mircoick/MWT-Miniprojekt/project/MWT_Miniprojekt.pdf

# Entwurf und Implementierung eines Rat-Race Kopplers

Tassilo Wolf Hertling
Hochschule Bremen
Elektrotechnik B. Eng.
Bremen, Deutschland
thertling@stud.hs-bremen.de

Mirco Ick
Hochschule Bremen
Elektrotechnik B. Eng.
Bremen, Deutschland
mick001@stud.hs-bremen.de

Zusammenfassung—In dieser Arbeit wird ein breitbandiger Rat-Race-Koppler unter Verwendung von gestuften Impedanzresonatoren vorgestellt und validiert. Das vorgeschlagene Design
wurde fur eine Mittenfrequenz von ¨ | | 5, 0 GHz optimiert und deckt
den Frequenzbereich von 4, 5 GHz bis 5, 5 GHz mit einer relativen Bandbreite von mindestens 20 % ab. Die Systemimpedanz
an den Ein- und Ausgangen betr ¨ | agt ¨ | 50 Ω. Die experimentellen
und simulierten Ergebnisse zeigen, dass der Reflexionskoeffizient (S11) im gesamten Betriebsband unter −10 dB liegt, wahrend ¨ eine Isolation zwischen den Ausgangen von mindestens 15 dB ¨ garantiert wird. Das Design wurde auf einem RO4003C-Substrat (Dicke: 0, 8 mm) mit einer kompakten Gesamtgrundflache von ¨ unter 40 mm × 40 mm realisiert.
Index Terms—Koppler, Mikrowellenschaltungen, Rat-Race, gestufter Impedanzresonator (SIR), Breitband, RO4003C.
I. EINLEITUNG
Der Rat-Race Koppler ist einer der klassischen Strukturen der Koppler. Diese sind fundamentale Bauelemente der Hochfrequenztechnik, die eine Leistungs- und Signalaufteilung ermoglichen. ¨
Wie in Abbildung 1 dargestellt, weisen die Leitungszweige zwischen den Ports 1, 2, 3 und 4 jeweils eine elektrische Lange ¨ von λ/4 auf. Einzig der verbindende Pfad zwischen Port 1 und Port 4 ist als 3λ/4-Leitungsabschnitt dimensioniert.

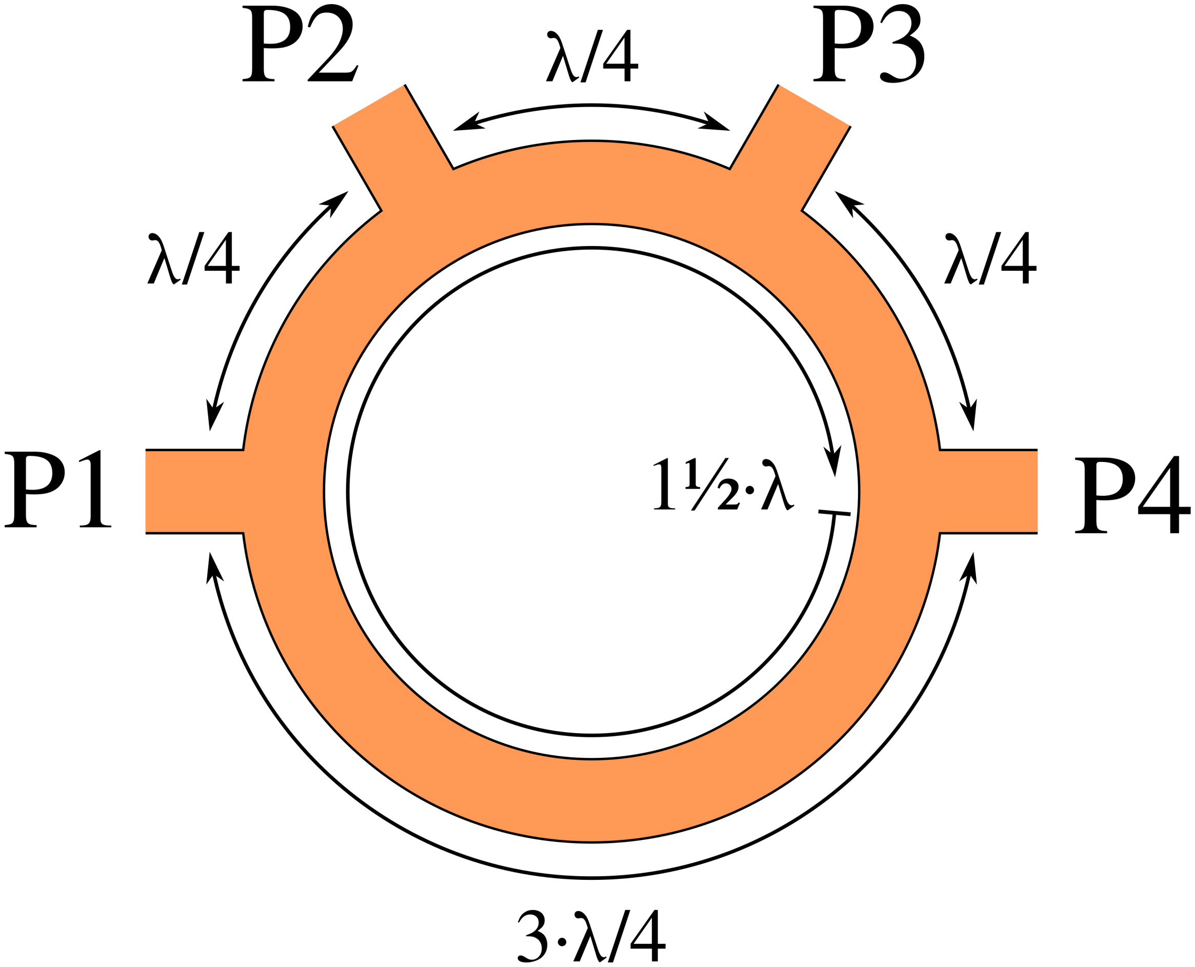
[picture p1: figure]

Abbildung 1. Struktur eines konventionellen Rat-Race-Kopplers gemaß [3] ¨

Aus dieser asymmetrischen Anordnung resultiert ein Gesamtumfang des Rings von 1

1/2 λ. Je nach gewahltem Ein- ¨ gangstor kommt es an den Ausgangstoren zu gezielten konstruktiven oder destruktiven Interferenzerscheinungen. Daraus resultieren die prazise Amplitudenteilung, die hohe Isolation ¨ der gegenuberliegenden Tore sowie die definierte Phasenbilanz ¨ (wahlweise 0

- oder 180◦ Phasenverschiebung). Eine Darstellung der verschiedenen Phasen bei verschiedener Signaleinspiesung ist der Abbildung 2 zu entnehmen.

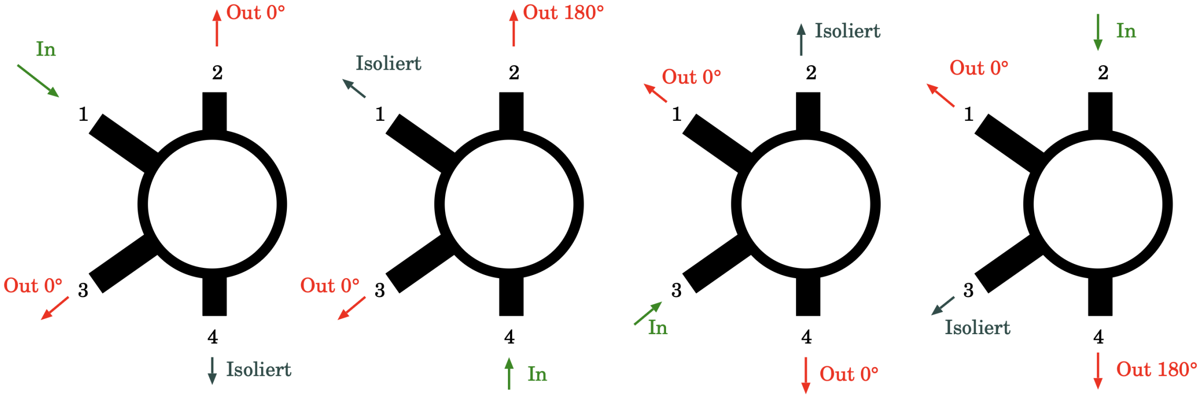
[picture p2: figure]

Abbildung 2. Beispielabbildung der Phasen eines Rat-Race Kopplers [2]

Klassische Ringkoppler sind schmalbandig, da sie auf eine Betriebsfrequenz ausgelegt sind. In [1] wurde untersucht wie dies vermieden werden kann.
Es wurden die Leitungsabschnitte des Rat-Race-Kopplers durch gestufte Impedanzresonatoren ersetzt. Diese Methodik ermoglichte eine Erweiterung der relativen Bandbreite ¨ auf mindestens 20 % im Frequenzbereich von 1, 7 GHz bis 2, 4 GHz (zentriert bei 2, 0 GHz), ohne dabei die geometrische
Grundflache der Schaltung zu vergr ¨ | oßern. ¨
Das Ziel dieser Arbeit bestand nun darin, diese Schaltung
auf einen hoheren Frequenzbereich von ¨ | | 4, 5 GHz bis 5, 5 GHz
bei einer Mittenfrequenz von 5, 0 GHz zu skalieren. Neben dieser Frequnezverschiebung waren weitere Vorgaben:
- Ein- und Ausgangsimpedanz: Z = 50 Ω
- Leistungsverteilung symmetrisch
- Ruckflussd ¨ | ampfung im gesamten Band: ¨ | S11 < −10 dB
- Isolation zwischen den Ausgangen: ¨ | S41 ≤ −15 dB
- Phasenfehler zwischen den Ausgangen: ¨
|S21 − S31| = 0◦ ± 5

◦
- Substrat: RO4003C, 0, 8 mm
- Maximale Platinen Große: ¨ | ≤ 40 mm × 40 mm
Dafur wurden zun ¨ | achst die Leitungsl ¨ | angen und -breiten ¨
berechnet. Anschließend wurde das Netzwerkmodell innerhalb der Simulationsumgebung AWR Microwave Office implementiert, um das Amplituden- und Phasenverhalten im Zielspektrum zu verbessern. Anschließend wurde die Platine geatzt und ¨ ein Vergleich zu den Theoriewerten durchgefuhrt. Auf diesen ¨ Entwicklungsverlauf wird nun in den nachfolgenden Kapiteln naher eingegangen. ¨

II. THEORIE
Fur die Bestimmung der Streuparameter (S-Parameter) und ¨ der Phasenbilanz zwischen den einzelnen Toren wird die Schaltung aus der Literatur als Basis herangezogen. Unter
Berucksichtigung der Resonanzbedingungen f ¨ | ur die jeweiligen ¨
λ/4- und 3λ/4-Leitungssegmente werden die geometrischen Abmessungen mathematisch hergeleitet.
Hierzu wird zunachst ¨ | uber die Lichtgeschwindigkeit ¨ | c und
die Mittenfrequenz f0 die Freiraumwellenlange ¨ | λ0 bestimmt:
λ0 = c f0 = | 2, 998 · 10⁸ m/s
| 5, 0 · 10⁹ Hz
= 59, 96 mm | (1)
In einer ersten Naherung wird f ¨ | ur die Wellenl ¨ | ange innerhalb ¨
des Dielektrikums (λm) die relative Permittivitatszahl des ¨ unbeschichteten Substrats (εr = 3, 55) herangezogen:

λm =

λ0
√
εr
| = 59, 96 mm
√
| 3, 55
≈ 31, 82 mm | (2)

Da diese Betrachtung die Feldausbreitung in die Luft ver-
nachlassigt, dient dieser Wert als erster Ausgangsparameter f ¨ | | ur¨
das anschließende Tuning und die finale Optimierung mittels der Tune-Funktion innerhalb von MW-Office.
Basierend auf der Materialwellenlange ¨ | λm werden die
Langen der Schaltungssegmente ¨ | L1 bis L7 berechnet. Wie in
Abbildung 3 dargestellt, wird die Ringstruktur zur Erweiterung der relativen Bandbreite mittels der Even-Odd-Methode in gestufte Impedanzresonatoren zerlegt. [1]

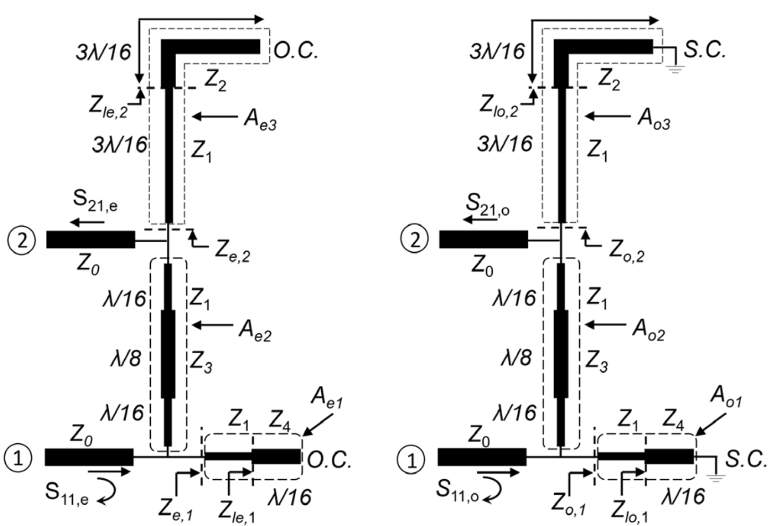
[picture p3: figure]

Abbildung 3. Leitungslangen aus der Literatur [1]. ¨

A. Berechnung der Leitungsabschnitte
Durch die Kopplung der im Paper definierten, von der
Wellenlange abh ¨ | angigen mathematischen Bedingungen mit der ¨
skalierten Materialwellenlange ¨ | λm = 31, 82 mm ergeben sich
die physikalischen Startlangen der Segmente wie folgt: ¨

L1 =

3λm
16

=

3 · 31, 82 mm
16
≈ 5, 97 mm | (3)

L2 + L5 = 2 ·

3λm
16

=

6 · 31, 82 mm
16

≈ 11, 93 mm (4)

L3 =

λm
8

=

31, 82 mm
8
≈ 3, 98 mm | (5)

L4 = 2 ·

λm
16

=

λm
8
≈ 3, 98 mm | (6)

L6 = L7 =

λm
16

=

31, 82 mm
16
≈ 1, 99 mm | (7)
Um die exakte Aufteilung der kombinierten Lange von ¨ | L2
und L5 zu bestimmen, wird die Symmetriebedingung der λ/4-Leitungen ausgenutzt. Dazu wurden zunachst die Leitungskur- ¨ ven (Bends) vernachlassigt. Unter dieser Annahmen muss der ¨ Pfad L2 exakt der elektrischen Lange der Leitung zwischen ¨ Port 1 und Port 3 entsprechen:

L2 = 2 · L7 + L4 =

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
≈ 7, 96 mm | (8)
Daraus ergibt sich die verbleibende Lange des Segments ¨ | L5
folgerichtig zu:

L5 = (L2 + L5) − L2 =

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
≈ 3, 98 mm (9)

Fur die Geometrie der Port Leitungen ( ¨ | L0) wird eine
fundamentale Lange von ¨ | λm/8 ≈ 3, 98 mm gewahlt. Da diese ¨
Leitungen exakt auf die Systemimpedanz von 50 Ω angepasst sind, andern sie den Wellenwiderstand theoretisch nicht und ¨ dienen im Layout primar der mechanischen Anbindung der ¨ SMA-Steckverbinder.
B. Spezifikation der Leitungsbreiten

Fur die erste Implementierung im Schaltungssimulator wer- ¨ den die Werte der Literatur [1] ubernommen. Diese Breiten ¨ sind in Tabelle II zusammengefasst. Auch hier wurde mithilfe des Tune-Tools spater genauere Anpassungen gemacht. ¨

Tabelle I
LEITUNGSBREITEN DER LITERATUR [1]
Designator | Physikalische Breite Wn (mm)
W0 | 1, 09
W1 | 0, 58
W2 | 0, 92
W3 | 0, 71
W4 | 1, 01
W5 | 0, 40

Diese Breiten bilden zusammen mit den berechneten
Langen das mathematische Fundament f ¨ | ur die Simulation in ¨
MW-Office.

III. NACHVOLLZUG

Die Schaltung wurde mithilfe von MW-Office implementiert. Hierbei wurden die Leitungen durch Mikrostreifen-Modelle (MLIN) modelliert. Die Verzweigungen an den Ports wurden
durch T-Stucke ( ¨ | MTEE) abgebildet, und das Substrat wurde
uber ein ¨ | MSUB-Element mit den spezifischen Materialpara-
metern des Rogers RO4003C-Substrats definiert (εr = 3, 55, h = 0, 8 mm, Verlustwinkel tan δ = 0, 0027, Kupferkaschierung t = 35 µm). Eine Darstellung des Simulationsmodels ist der Abbildung 4 zu entnehmen.

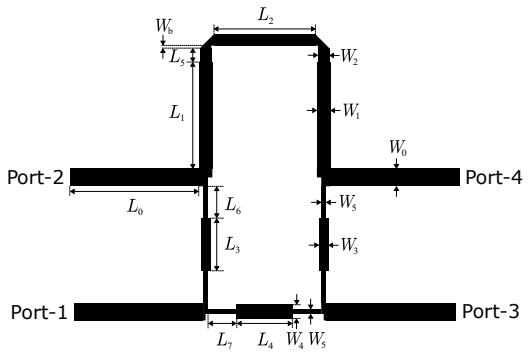
[picture p4: figure]
Port-2; Port-1; Port-4; Port-3

Abbildung 4. Topologie des Rat-Race Kopplers

Die erste Simulation mit den hergeleiteten Startwerten zeigte, eine Verschiebung der optimalen Parameter zu niedrigeren Frequenzen. Dies begrundet sich durch die effektive ¨ Permittivitat, da ein Teil des elektromagnetischen Feldes im ¨
Außenraum verlauft, was die gef ¨ | uhrte Wellenl ¨ | ange vergr ¨ | oßert. ¨
Ebenso besitzen geometrische Diskontinuitaten an T-St ¨ | ucken ¨
und Kurven parasitare Komponenten, welche die elektrische ¨
Gesamtlange des Rings k ¨ | unstlich verl ¨ | angern. ¨

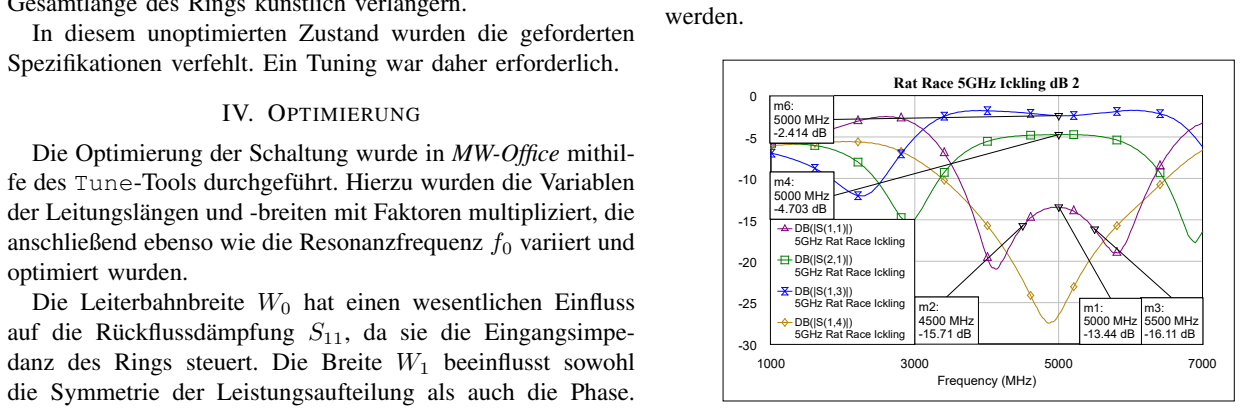
[picture p5: figure]
auf die Ruckflussd ¨; ampfung ¨; S11, da sie die Eingangsimpe-; werden.; Frequency (MHz); Rat Race 5GHz Ickling dB 2; 5000 MHz -2.414 dB; m4: 5000 MHz -4.703 dB

In diesem unoptimierten Zustand wurden die geforderten Spezifikationen verfehlt. Ein Tuning war daher erforderlich.

| IV. OPTIMIERUNG

Die Optimierung der Schaltung wurde in MW-Office mithilfe des Tune-Tools durchgefuhrt. Hierzu wurden die Variablen ¨ der Leitungslangen und -breiten mit Faktoren multipliziert, die ¨ anschließend ebenso wie die Resonanzfrequenz f0 variiert und optimiert wurden.
Die Leiterbahnbreite W0 hat einen wesentlichen Einfluss

danz des Rings steuert. Die Breite W1 beeinflusst sowohl die Symmetrie der Leistungsaufteilung als auch die Phase. Dies erfordert einen Kompromiss zwischen der Einhaltung der Amplitudensymmetrie und der Minimierung des Phasenfehlers zwischen den Ausgangen. Im vorliegenden Entwurf wurde die ¨ Optimierung des Phasenfehlers priorisiert. Da die Wellenlange ¨ λ mit der Frequenz f gekoppelt ist, verandert ¨ L0 die Mittenfrequenz und wurde auf 5 GHz angepasst. L1 beeinflusst die Symetrie des Phasenfehlers so wie die Verschiebung von S41, da es im 3/4λ Teil der Leitung liegt und somit das Verhaltniss ¨
andert. Die Zuleitungsl ¨ | ange ¨ | L6 wirkt sich vor allem auf die
Symmetrie der Bandbreite aus und wurde ebenfalls fur eine ¨ Mittenfrequenz von 5 GHz dimensioniert. Wb geht aus der MW-Office Schematic heraus.
Abbildung 5 zeigt, dass die wesentlichen Anforderungen
weitgehend erfullt wurden. Wie an Marker ¨ | m1 zu erkennen
ist, liegt die Mittenfrequenz der Anpassung bei 5 GHz. Das Minimum der Isolation S41 liegt zwar versetzt zu 5 GHz, was jedoch akzeptabel ist um die ubrigen Parameter besser ¨ einzustellen. Uber die gesamte geforderte Bandbreite von ¨
4, 5 GHz bis 5, 5 GHz bleibt die Ruckflussd ¨ | ampfung ¨ | S11 un-
terhalb von -10 dB. Zur Beurteilung der Isolation wird S41

Tabelle II
U¨ BERSICHT DER VERWENDETEN LEITUNGSBREITEN UND -LANGEN ¨

BASIEREND AUF [1]

Variable | Faktor | Wert in mm
w0 | 1,21 | 1,3189
w1 | 1,75 | 1,0150
w2 | 0,93 | 0,8556
w3 | 1,03 | 0,7313
w4 | 1,05 | 1,0605
w5 | 0,91 | 0,3640
l0 | 1,23 | 9,6317
l1 | 1,354 | 7,9522
l2 | – | 7,5595
l3 | 1,01 | 3,9545
l4 | 1,07 | 4,1894
l5 | 1,147 | 1,0318
l6 | 1,21 | 2,3688
l7 | 1,09 | 2,1338

betrachtet diese kann analog zur Isolation S31 zwischen den Ausgangen betrachtet werden. Dieser Wert bleibt im gesamten ¨ Frequenzband stets unter −15 dB. Zudem wurde die geforderte relative Bandbreite von mindestens 20% erreicht. Eine perfekte Amplitudensymmetrie konnte aufgrund der zuvor erwahnten ¨ Priorisierung des Phasenfehlers nicht vollstandig realisiert ¨

DB(|S(1,1)|) 5GHz Rat Race Ickling DB(|S(2,1)|)

5GHz Rat Race Ickling DB(|S(1,3)|) 5GHz Rat Race Ickling

DB(|S(1,4)|) 5GHz Rat Race Ickling | m2: 4500 MHz -15.71 dB | m1: m3: 5000 MHz 5500 MHz -13.44 dB -16.11 dB

Abbildung 5. Simulierte S-Parameter, Betrag in dB, des Rat-Race-Kopplers bei 5 GHz

In Abbildung 6 ist zu erkennen, dass die Phasendifferenz uber die gesamte betrachtete Bandbreite innerhalb einer Tole- ¨ ranz von 5° liegt.

V. FERTIGUNG
Nach der theoretischen Betrachtung wurde die Platine nun
geazt und anschließend gel ¨ | otet. In Abbildung 7 ist die fertig ¨
gelottete Platine zu sehen. ¨
| VI. MESSUNG
Vor der messtechnischen Charakterisierung wurde der Netzwerkanalysator kalibriert. Anschließend wurden die S-Parameter der gefertigten Schaltung ermittelt.
Abbildung 8 zeigt, dass das gemessene S11 gegenuber der ¨ Simulation leicht frequenzverschoben ist. Dennoch bleibt der
Wert uber die gesamte Bandbreite unterhalb von ¨ | −10 dB,
sodass eine ausreichend gute Anpassung gewahrleistet ist. ¨

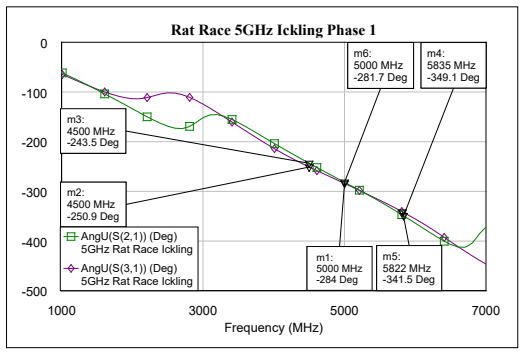
[picture p6: figure]
Frequency (MHz); Rat Race 5GHz Ickling Phase 1; m3: 4500 MHz -243.5 Deg; m2: 4500 MHz -250.9 Deg AngU(S(2,1)) (Deg)

| m6: m4: 5000 MHz 5835 MHz -281.7 Deg -349.1 Deg
5GHz Rat Race Ickling AngU(S(3,1)) (Deg) 5GHz Rat Race Ickling | m1: 5000 MHz -284 Deg | m5: 5822 MHz -341.5 Deg

Abbildung 6. Simulierter Phasenverlauf des Rat-Race-Kopplers bei 5 GHz

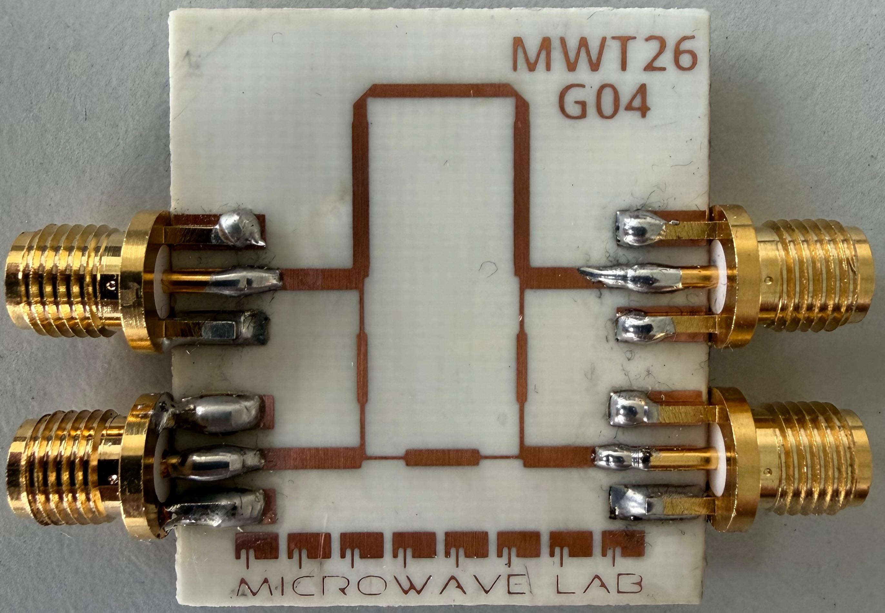
[picture p7: figure]

Abbildung 7. Fotografie der geatzten Platine des Rat-Race-Kopplers ¨

S21 ist Koharent und divergiert erst ab ¨ | 5, 5 GHz von den
Theoriewerten.
Aus Abbildung 9 geht hervor, dass S41, im unteren Frequenzberreich, leicht verschoben von der EM-Analyse
verlauft. ¨ | S31 verhalt sich im gew ¨ | unschten Frequenzbereich ¨
weitesgehend erwartend. Es ist jedoch eine Asymeterie von von 2 dB festzustellen.
In Abbildung 10 ist eine deutliche Abweichung der gemessenen Phasendifferenz von den theoretischen Werten zu
beobachten. Dies ist primar auf ¨ | S31 zuruckzuf ¨ | uhren, dessen ¨
Phasenverlauf einen unerwarteten Verlauf hat. Im Gegensatz

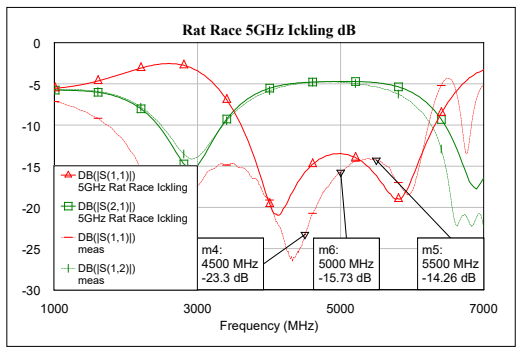
[picture p8: figure]
Frequency (MHz); Rat Race 5GHz Ickling dB

DB(|S(1,1)|) 5GHz Rat Race Ickling DB(|S(2,1)|)

5GHz Rat Race Ickling DB(|S(1,1)|) meas | m4: m6: | m5:
DB(|S(1,2)|) meas | 4500 MHz 5000 MHz -23.3 dB -15.73 dB | 5500 MHz -14.26 dB

Abbildung 8. Vergleich der EM-Analyse und gemessenen S-Parameter S11 und S21

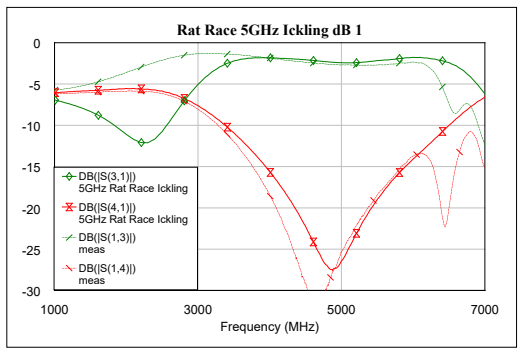
[picture p9: figure]
Frequency (MHz); Rat Race 5GHz Ickling dB 1; 5GHz Rat Race Ickling DB(|S(1,3)|) meas; DB(|S(1,4)|) meas

DB(|S(3,1)|) 5GHz Rat Race Ickling DB(|S(4,1)|)

Abbildung 9. Vergleich der EM-Analyse und gemessenen S-Parameter S31

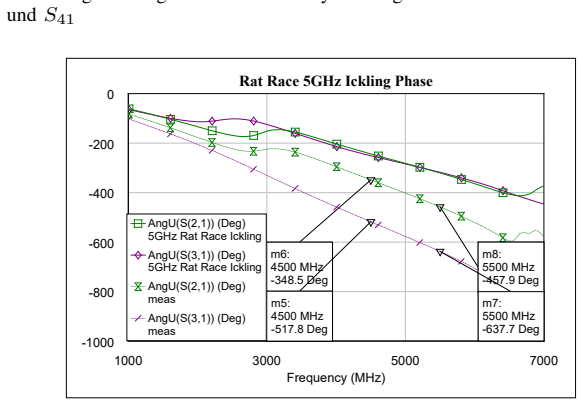
[picture p10: figure]
und S41; Frequency (MHz); Rat Race 5GHz Ickling Phase; meas AngU(S(3,1)) (Deg) meas; m5: 4500 MHz -517.8 Deg; m7: 5500 MHz -637.7 Deg

AngU(S(2,1)) (Deg) 5GHz Rat Race Ickling

AngU(S(3,1)) (Deg) 5GHz Rat Race Ickling AngU(S(2,1)) (Deg) | m6: 4500 MHz -348.5 Deg | m8: 5500 MHz -457.9 Deg

Abbildung 10. Vergleich des simulierten und gemessenen Phasenverlaufs

dazu folgt die Phase von S21 den simulierten Werten lediglich mit einem konstanten Offset.

VII. DISKUSSION
Die gefertigte Schaltung zeigt insgesamt ein Verhalten, das unter Berucksichtigung typischer Fertigungstoleranzen gut mit ¨ dem theoretischen Modell ubereinstimmt. Eine signifikante ¨ Abweichung zeigt sich lediglich im Phasenverlauf von S31.
Diese Diskrepanz konnte auf die sehr kleinen Leitungsl ¨ | angen ¨
zuruckzuf ¨ | uhren sein, da hier bereits minimale Abweichungen ¨
der Langen enorme Kurven ¨ | anderungen mit sich bringen. ¨

VIII. FAZIT
Es wurde im besprochenen Design ein Rat-Race-Koppler fur¨ eine Mittenfrequenz von 5 GHz entworfen, simuliert und messtechnisch validiert. Trotz leichter Asymmetrien und messbarer Phasenabweichungen in einem der Koppelpfade erfullt das ¨ realisierte Design die grundlegenden Systemanforderungen, insbesondere hinsichtlich der relativen Bandbreite und der
Ruckflussd ¨ | ampfung. ¨

LITERATUR

[1] A. K. Sahoo und K. Rawat, ”

A wideband rat-race coupler using stepped impedance resonator“, 2018 IEEE MTT-S International Wireless Symposium (IWS), Chengdu, China, 2018, pp. 1-3.
[2] Prof. Dr. S. Peik, ”Coupler and power divider”, Vorlesungsskript, Hochschule Bremen, 2026.
[3] https://de.wikipedia.org/wiki/Ringkoppler, 2026
