mircoick/MWT-Miniprojekt/project/MW-Office/5GHz Rat Race Ickling.dxf

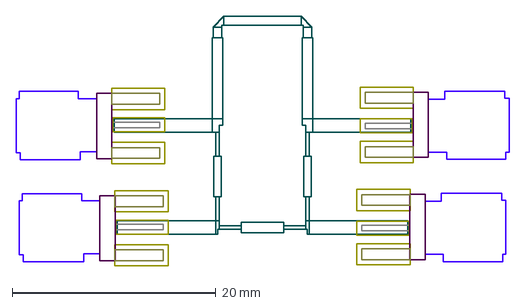
[picture p11: CAD file, 2026-07-04]
project/MW-Office/5GHz Rat Race Ickling.dxf
48.3 x 24.4 mm
