mircoick/MWT-Miniprojekt/project/Schematic.pdf

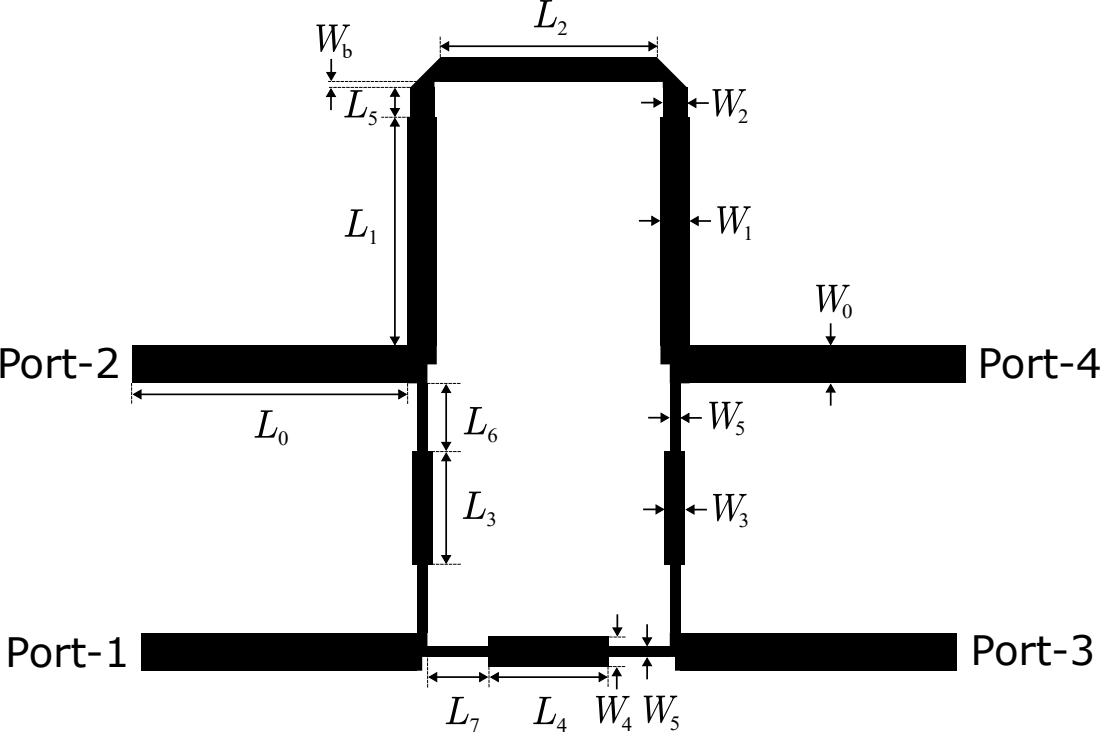
[picture p12: page 1]
Port-2; Port-1; Port-4; Port-3
