mircoick/MWT-Miniprojekt/project/db.pdf

# Rat Race 5GHz Ickling dB

-5

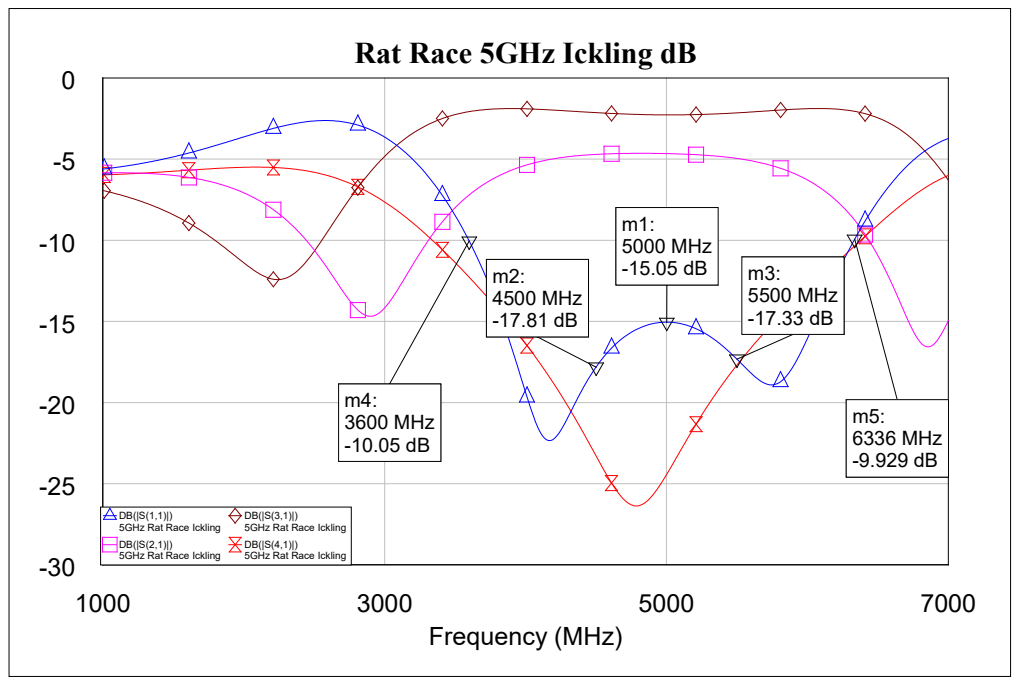
[picture p13: page 1]
Frequency (MHz); 5500 MHz -17.33 dB

5000 MHz -15.05 dB m2: 4500 MHz -17.81 dB | m3:

m4:
3600 MHz -10.05 dB | m5: 6336 MHz -9.929 dB

DB(|S(1,1)|) DB(|S(3,1)|) 5GHz Rat Race Ickling 5GHz Rat Race Ickling 5GHz Rat Race Ickling 5GHz Rat Race Ickling
