mircoick/MWT-Miniprojekt/project/phase.pdf

## Rat Race 5GHz Ickling Phase

200

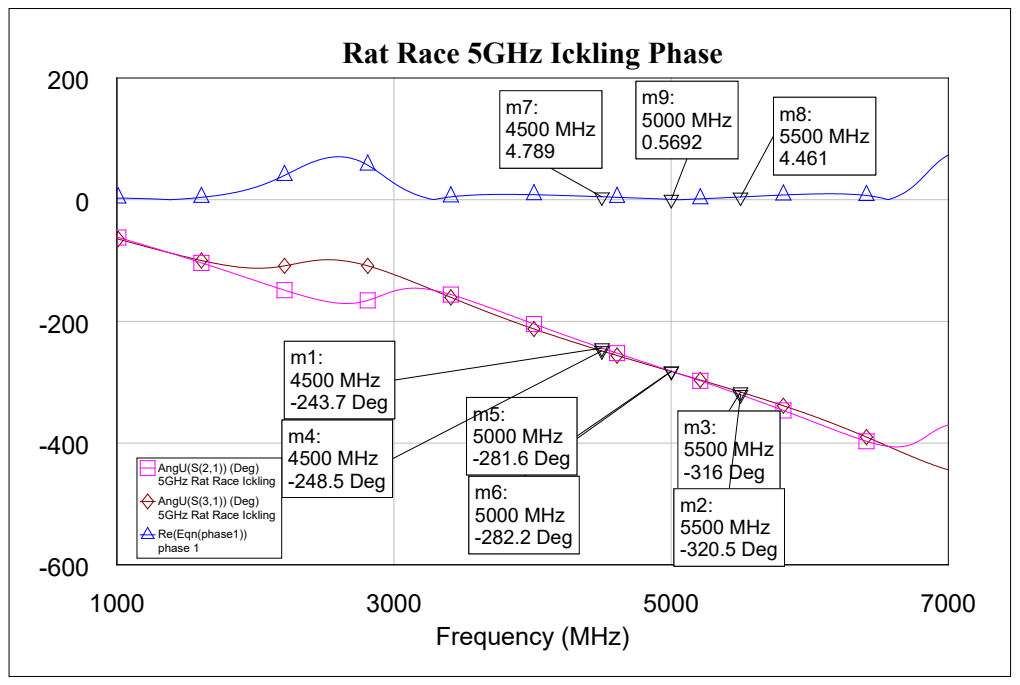
[picture p14: page 1]
Frequency (MHz); m9: 5000 MHz 0.5692; m8: 5500 MHz 4.461; m7: 4500 MHz 4.789; m3: 5500 MHz; AngU(S(2,1)) (Deg)

m1: 4500 MHz -243.7 Deg m4: | m5: 5000 MHz

4500 MHz -248.5 Deg 5GHz Rat Race Ickling AngU(S(3,1)) (Deg) 5GHz Rat Race Ickling Re(Eqn(phase1)) phase 1 | -281.6 Deg m6: 5000 MHz -282.2 Deg | -316 Deg m2: 5500 MHz -320.5 Deg
