mircoick/MWT-Miniprojekt/project/MW-Office/dbcompare1.pdf

# Rat Race 5GHz Ickling dB 1

-5

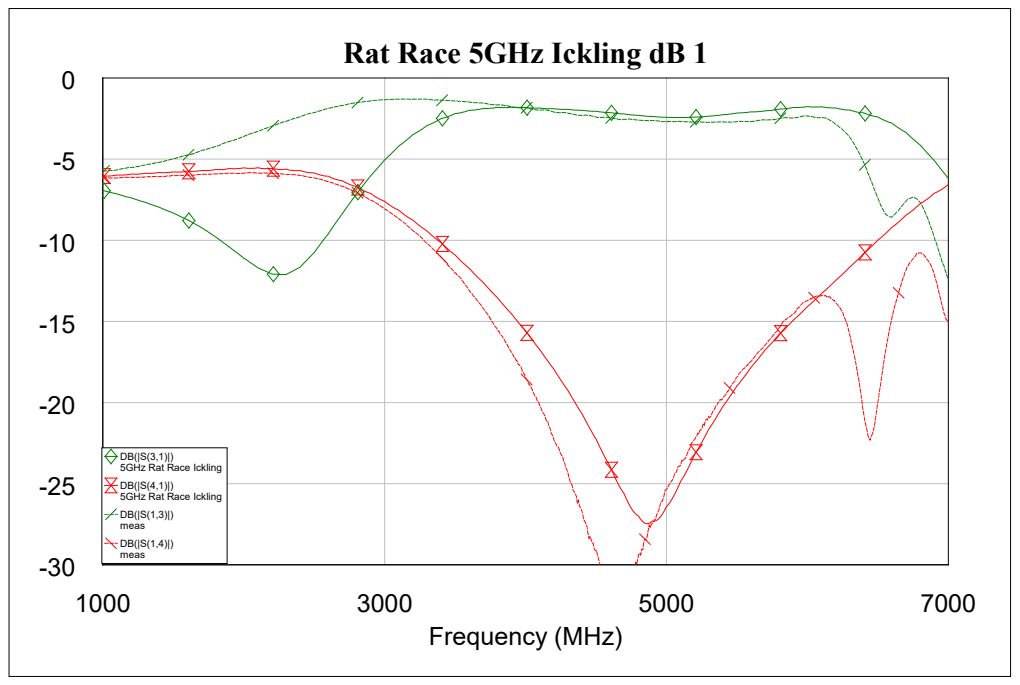
[picture p15: page 1]
Frequency (MHz); DB(|S(3,1)|) 5GHz Rat Race Ickling

5GHz Rat Race Ickling
DB(|S(1,3)|) meas DB(|S(1,4)|) meas
