mircoick/MWT-Miniprojekt/project/MW-Office/dbcompare2.pdf

## Rat Race 5GHz Ickling dB

-5

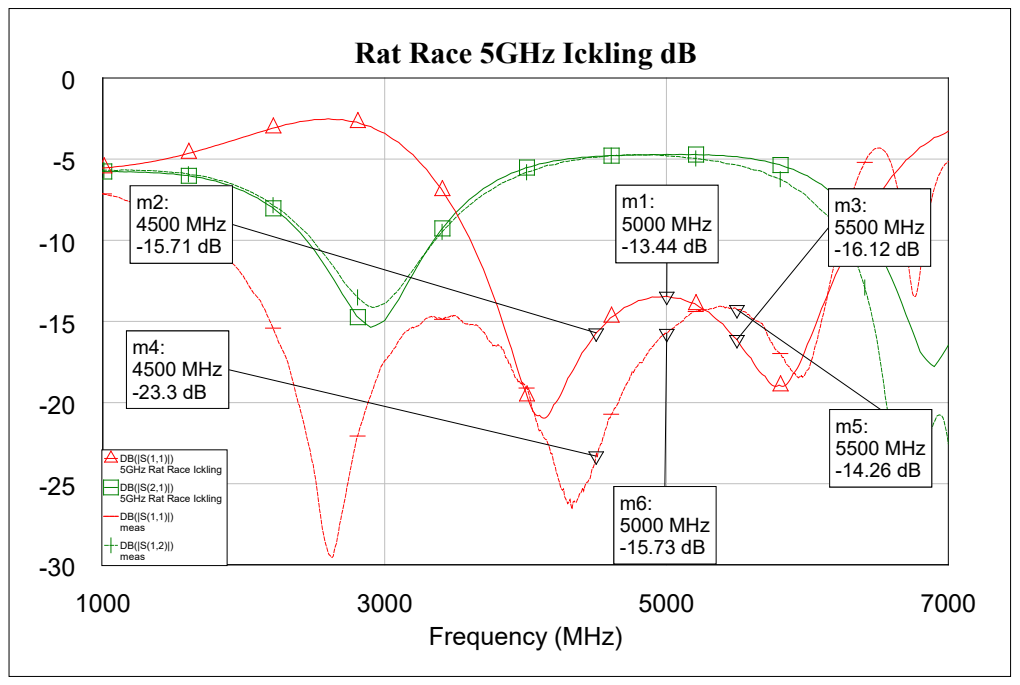
[picture p16: page 1]
Frequency (MHz); m2: 4500 MHz; 5000 MHz

m1: | m3: 5500 MHz

m4: 4500 MHz -23.3 dB

DB(|S(1,1)|) 5GHz Rat Race Ickling | | m5: 5500 MHz -14.26 dB

5GHz Rat Race Ickling DB(|S(1,1)|) meas DB(|S(1,2)|) meas | m6: 5000 MHz -15.73 dB
