mircoick/MWT-Miniprojekt/project/MW-Office/phasecompare.pdf

## Rat Race 5GHz Ickling Phase

0

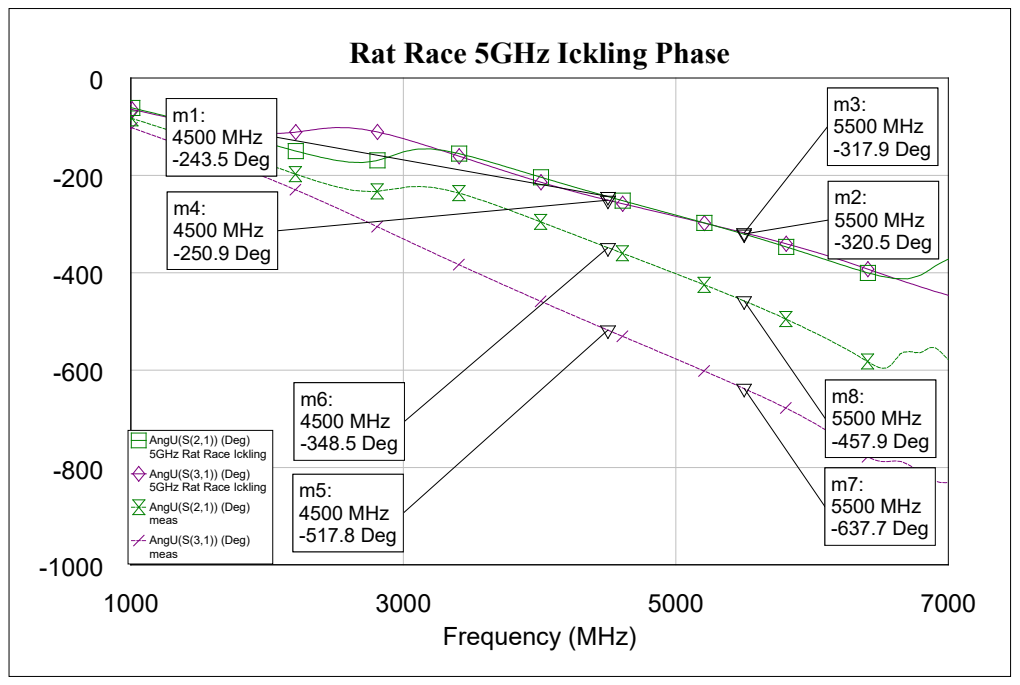
[picture p17: page 1]
Frequency (MHz); -348.5 Deg; 5500 MHz -320.5 Deg; m1: 4500 MHz -243.5 Deg; AngU(S(2,1)) (Deg)

m3: 5500 MHz -317.9 Deg

m4: 4500 MHz -250.9 Deg | m2:

m6: 4500 MHz 5GHz Rat Race Ickling | m8: 5500 MHz -457.9 Deg

AngU(S(3,1)) (Deg) 5GHz Rat Race Ickling m5: AngU(S(2,1)) (Deg) 4500 MHz meas -517.8 Deg AngU(S(3,1)) (Deg) meas | m7: 5500 MHz -637.7 Deg
